theboot999/Teensy-DIY/Photos/PCB4.PNG

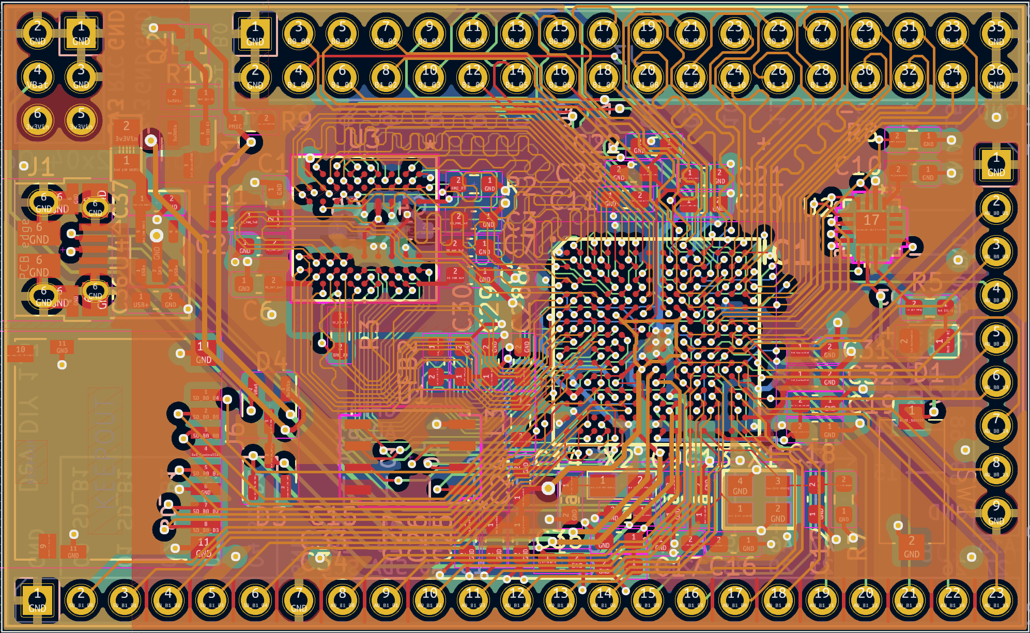
Photos/PCB4.PNG
