theboot999/Teensy-DIY/Photos/PCB3.PNG

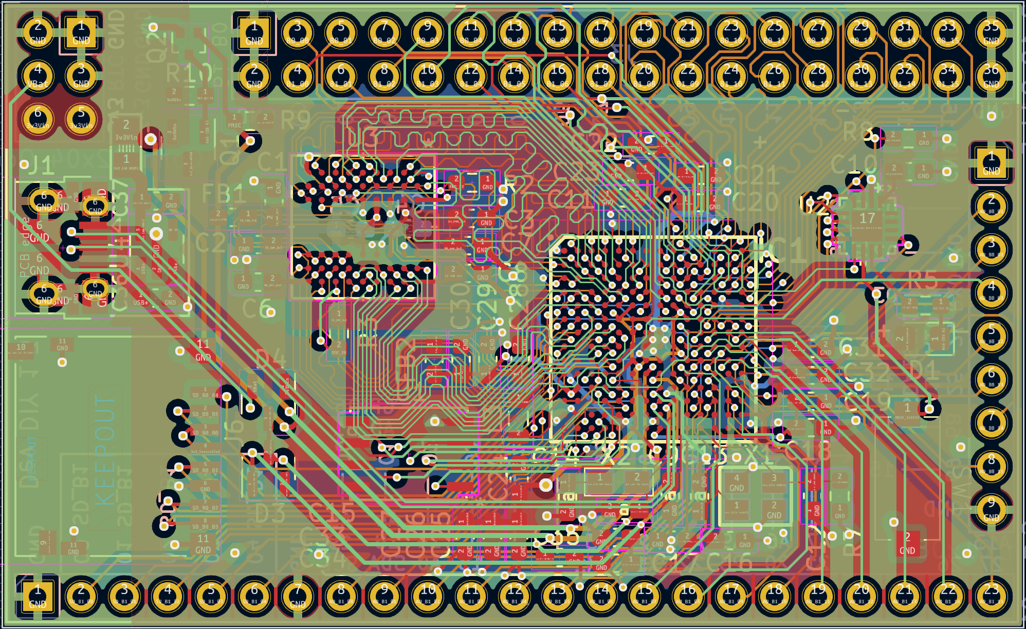
Photos/PCB3.PNG
