theboot999/Teensy-DIY/Photos/Bottom.jpg

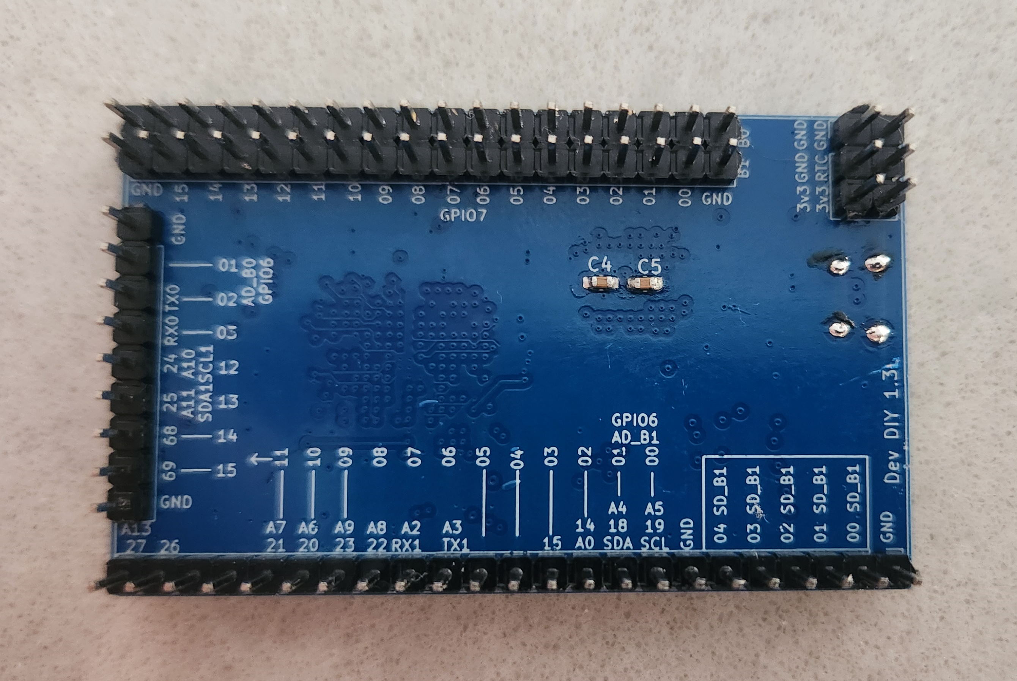
Photos/Bottom.jpg
