theboot999/Teensy-DIY/Photos/Compare.jpg

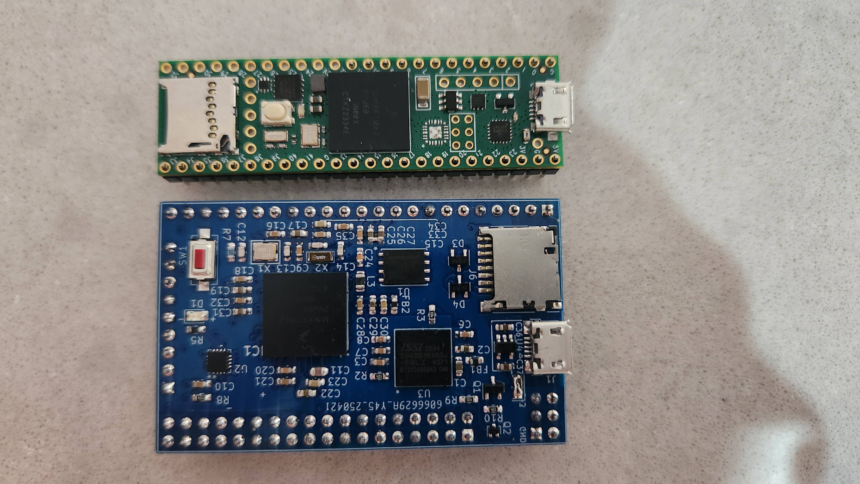
Photos/Compare.jpg
