theboot999/Teensy-DIY/Photos/PCB1.PNG

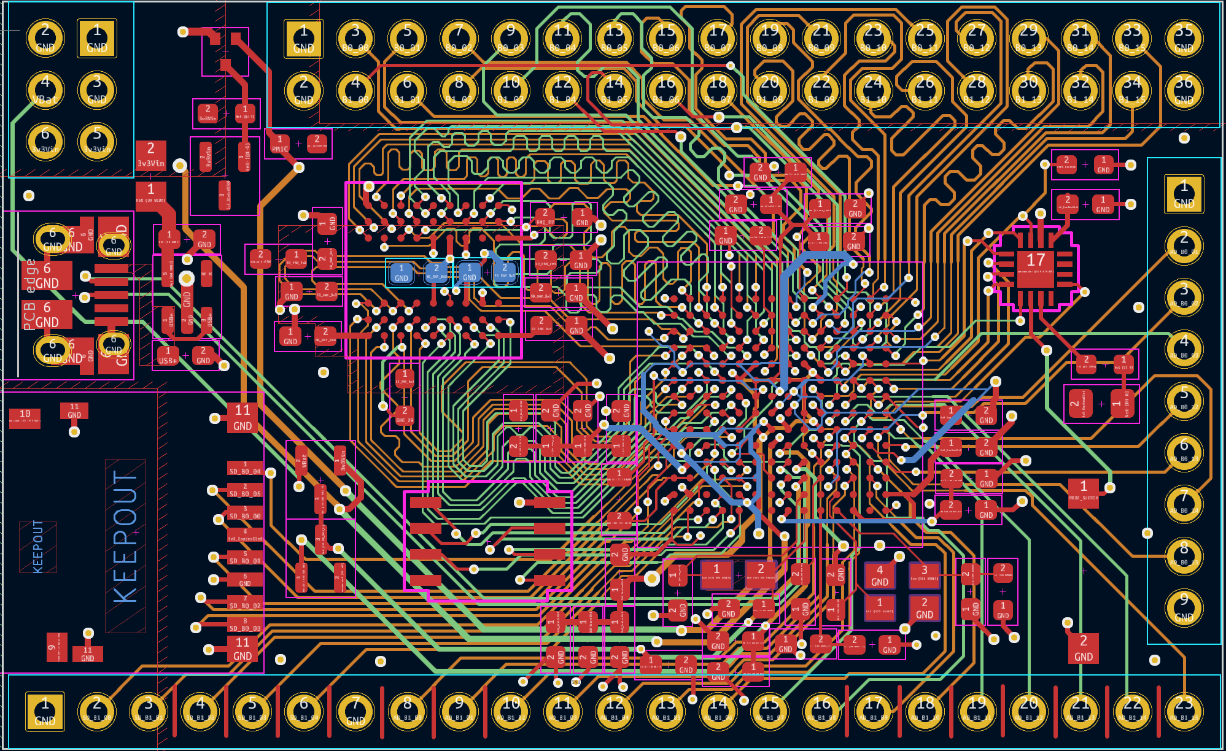
Photos/PCB1.PNG
