theboot999/Teensy-DIY/Photos/PCB2.PNG

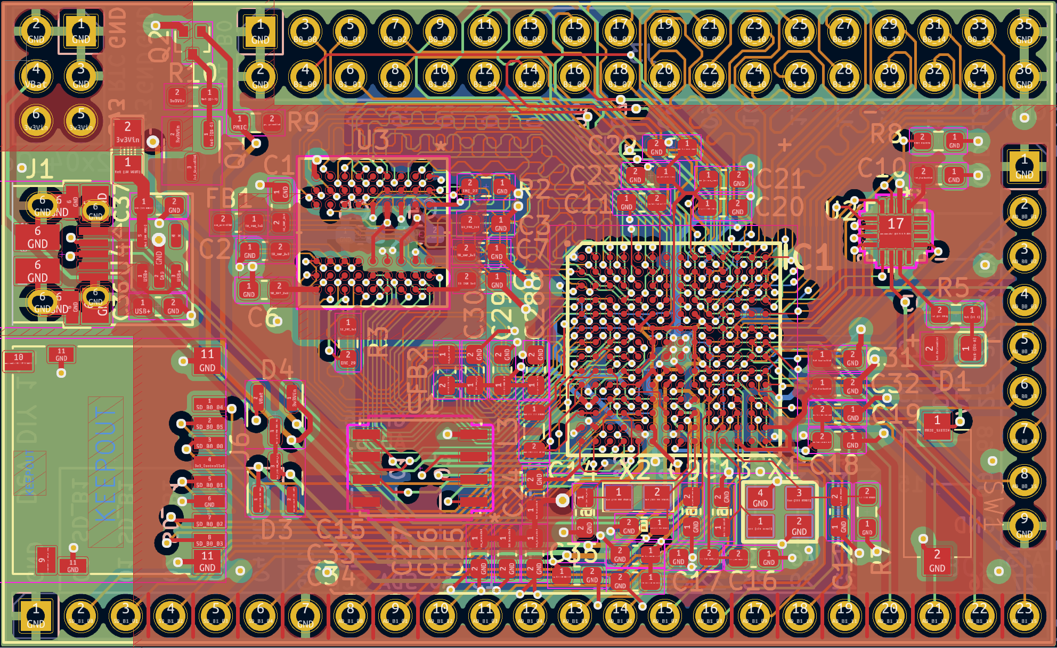
Photos/PCB2.PNG
