theboot999/Teensy-DIY/Photos/PCB5.PNG

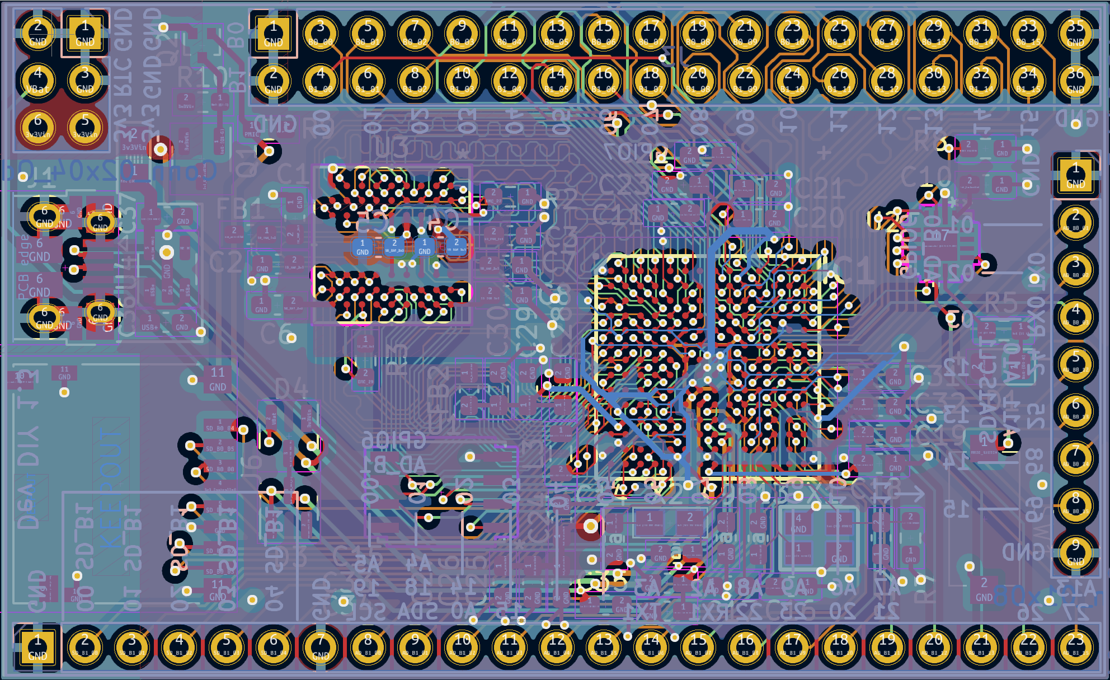
Photos/PCB5.PNG
