theboot999/Teensy-DIY/Photos/Top.jpg

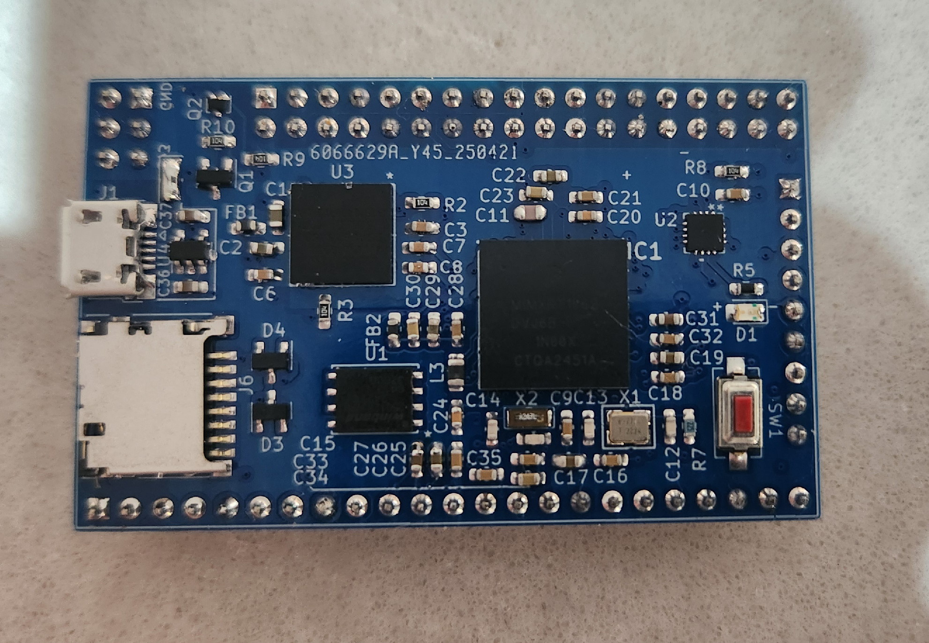
Photos/Top.jpg
