theboot999/Teensy-DIY/Parts List.xlsx

Qty | Description | Product | Package Size | Designator | Link
1 | Microcontroller 12x12 | MIMXRT1062DVJ6B_BGA196 | BGC 12x12 | IC1 | https://au.mouser.com/ProductDetail/NXP-Semiconductors/MIMXRT1062DVJ6B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
1 | Flash Memory 128 mB | W25Q128JVPIM | WSON-8 | U1 | https://au.mouser.com/ProductDetail/Winbond/W25Q128JVPIM?qs=qSfuJ%252Bfl%2Fd62hi5N%252Bd7%252B%252BA%3D%3D
1 | Boot Loader | MKL02Z32_T4_QFN16 | QFN-16 | U2 | https://www.pjrc.com/store/ic_mkl02_t4.html
1 | Ram Chip | IS42S16160J-6BLI | BGA-54 | U3 | https://au.mouser.com/ProductDetail/ISSI/IS42S16160J-6BLI?qs=bHq4TaS7gBeegvGnUO%252BBjw%3D%3D
1 | P Channel Mosfet | DMG2305UXQ-7 | SOT-23-3 | Q1 | https://www.mouser.com/ProductDetail/Diodes-Incorporated/DMG2305UXQ-7?qs=60RJRzIpcl%2FUiAojHt1c9w%3D%3D
1 | N Channel Mosfet | RE1C002UNTCL | SOT-416 | Q2 | https://au.mouser.com/ProductDetail/ROHM-Semiconductor/RE1C002UNTCL?qs=npTsUczJOtMVMYYXsT30%252BQ%3D%3D
1 | USB-B Micro | 10103594-0001LF |  | J1 | https://au.mouser.com/ProductDetail/Amphenol-FCI/10103594-0001LF?qs=EnLMdcWnKABYZwdMsmC%2Fag%3D%3D
1 | Clock 32.768khz | Q13FC1350000400 | 3.2 mm x 1.5 mm | X2 | https://au.mouser.com/ProductDetail/Epson-Timing/FC-135-32.7680KA-A5?qs=f9yNj16SXrJ7J65t%252BHv0JQ%3D%3D
1 | Clock 24mhz | TSX-3225 24.0000MF20G-AC0 | 3.2 mm x 2.5 mm | X1 | https://au.mouser.com/ProductDetail/Epson-Timing/TSX-3225-24.0000MF20G-AC0?qs=wwacUt%252BV97uUWXrbfzMUpw%3D%3D
2 | BAT54C Shottky Diode | BAT54C/SOT23/TO-236AB | SOT-23-3 | D3, D4 | https://au.mouser.com/ProductDetail/Nexperia/BAT54C215?qs=me8TqzrmIYV5SKKt13YKQA%3D%3D&gad_source=1
1 | SD CARD | DM3D-SF(41) |  | J6 | https://au.mouser.com/ProductDetail/Hirose-Connector/DM3D-SF41?qs=tTj%252BmQ3KZwbYpj6JXEwW%2Fg%3D%3D
1 | Button | PTS636SKG25JSMTR LFS |  | SW1 | https://au.mouser.com/ProductDetail/CK/PTS636SKG25JSMTR-LFS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
1 | 3.3V Regulator | AP2112K-3.3TRG1 | SOT-25-5 | U4 | https://au.mouser.com/ProductDetail/Diodes-Incorporated/AP2112K-3.3TRG1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
2 | Ferrite Bead 0603 120Ω | MH1608-121Y | 603 | FB1, FB2 | https://www.mouser.com/ProductDetail/Bourns/MH1608-121Y
1 | Inductor 0805 4.7UH | LQM21PN4R7MGRD | 805 | L3 | https://au.mouser.com/ProductDetail/Murata-Electronics/LQM21PN4R7MGRD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
1 | Led 0805 Red | SML-LX0805IC-TR | 805 | D1 | https://au.mouser.com/ProductDetail/Lumex/SML-LX0805IC-TR?qs=sGAEpiMZZMt82OzCyDsLFLxiYV1ppX3oZmGBhJKofL4%3D
6 | 100k Resistor 0603 | ERA-3AED104V | 603 | R1, R2, R3, R7, R8, R9, R10 | https://au.mouser.com/ProductDetail/Panasonic/ERA-3AED104V
1 | 1k Resistor 0603 | CRCW06031K00FKED | 603 | R5 | https://au.mouser.com/ProductDetail/Vishay-Dale/CRCW06031K00FKED
1 | 2.2M Resistor 0603 | RK73H1JRTTD2204F | 603 | R7 | https://au.mouser.com/ProductDetail/KOA-Speer/RK73H1JRTTD2204F
6 | 0.1uf Capacitor 0603 | KGM15AR71A104KT | 603 | C3, C4, C5, C6, C7, C8 | https://au.mouser.com/ProductDetail/KYOCERA-AVX/KGM15AR71A104KT?qs=OcgtsXO%252B3guqUxqtWAbA9A%3D%3D
6 | 4.7uf Capacitor 0603 | LMK107BJ475KA-T | 603 | C2, C17, C19, C22, C26, C29 | https://au.mouser.com/ProductDetail/TAIYO-YUDEN/LMK107BJ475KA-T?qs=PzICbMaShUfCoRlxZeLF0g%3D%3D
5 | 10pf Capacitor 0603 | VJ0603A100FXQPW1BC | 603 | C11, C12, C13, C14, C15 | https://au.mouser.com/ProductDetail/Vishay-Vitramon/VJ0603A100FXQPW1BC?qs=ivd3pYEy43PNDQsvAciBCA%3D%3D
1 | 22uf Capacitor 0603 | KAM15CT70J226KT | 603 | C1 | https://au.mouser.com/ProductDetail/KYOCERA-AVX/KAM15CT70J226KT
10 | 0.22uf Capacitor 0603 | GRM188R71A224KA01J | 603 | C9,C10,C16,C18,C21,C25,C28,C32,C33,C35 | https://au.mouser.com/ProductDetail/Murata-Electronics/GRM188R71A224KA01J?qs=o%252B57EFQVsgKpqp8gwRHOAA%3D%3D
2 | 0.01uf Capacitor 0603 | 885012206014 | 603 | C20, C24 | https://au.mouser.com/ProductDetail/Wurth-Elektronik/885012206014?qs=0KOYDY2FL2%252BG40IIH78uMA%3D%3D
2 | 10uf Capacitor 0603 | GRM188R61A106ME69D | 603 | C30,C23,C34 | https://au.mouser.com/ProductDetail/Murata-Electronics/GRM188R61A106ME69D?qs=o98hbGm2QKGN31NsNZp5HQ%3D%3D
4 | 2.2uf Capacitor 0603 | LMK107B7225KA-TR | 603 | C27,C31,C36,C37 | https://au.mouser.com/ProductDetail/TAIYO-YUDEN/LMK107B7225KA-TR?qs=vF%252B8ahGVildKPUFyo2XZuA%3D%3D
