theboot999/Teensy-DIY/Schematic.pdf

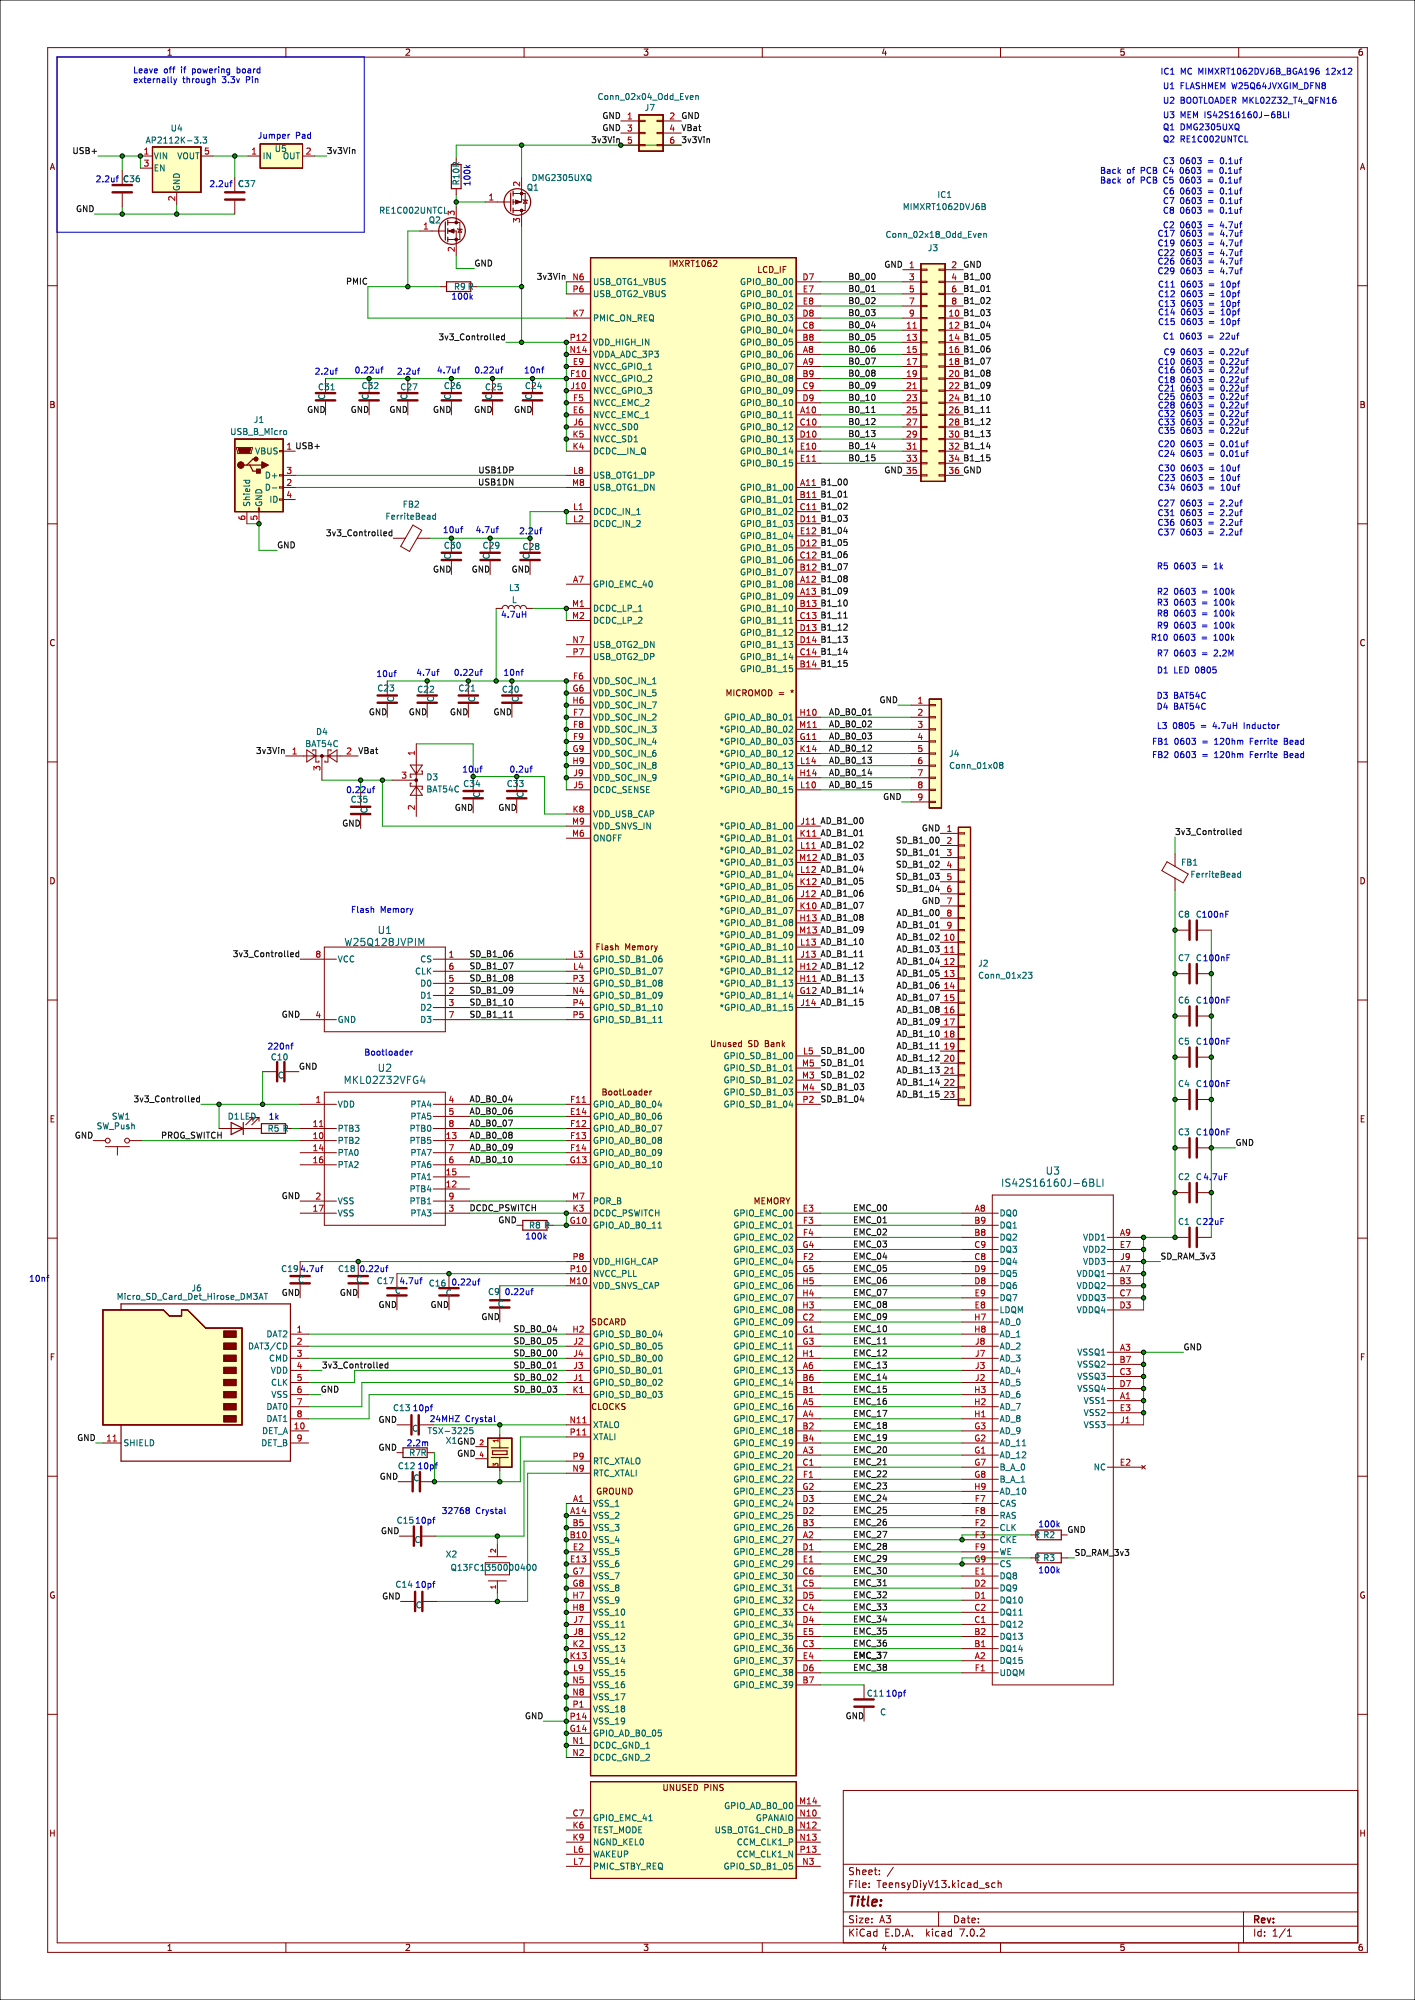
[picture p10: page 1]
