theboot999/Teensy-DIY/Kicad/TeensyDiyV13/TeensyDiyV13.kicad_pcb

## KiCad design Kicad/TeensyDiyV13/TeensyDiyV13.kicad_pcb (2025-04-29)

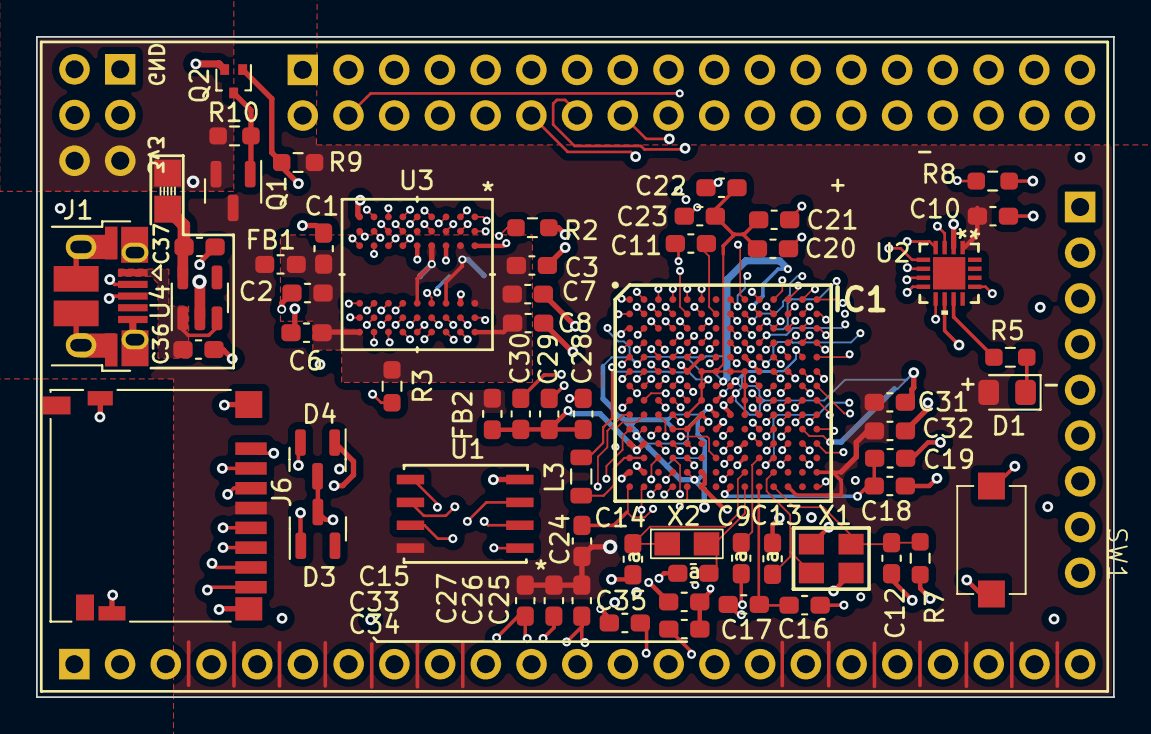
[picture p11: board TeensyDiyV13.kicad_pcb from above]

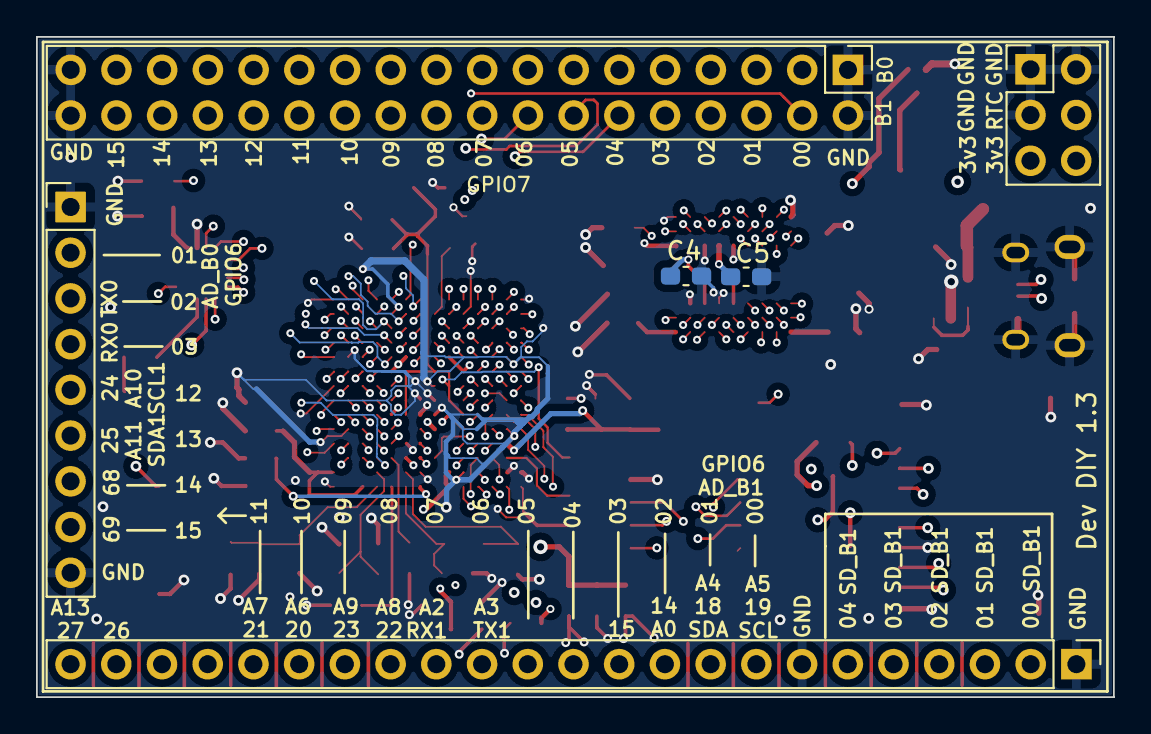
[picture p12: board TeensyDiyV13.kicad_pcb from below]

Board: 4 copper layers, 59.8 x 36.7 mm, 67 parts (6 on the bottom side), 146 nets.

Parts:
C1, C2, C3, C4, C5, C6, C7, C8, C9, C10, C11, C12, C13, C14, C15, C16, C17, C18, C19, C20, C21, C22, C23, C24, C25, C26, C27, C28, C29, C30, C31, C32, C33, C34, C35, C36, C37: C; C_0603_1608Metric_Pad1.08x0.95mm_HandSolder
D1: LED; LED_0805_2012Metric_Pad1.15x1.40mm_HandSolder
D3, D4: BAT54C; SOT-23
FB1, FB2: FerriteBead; L_0603_1608Metric_Pad1.05x0.95mm_HandSolder
IC1: MIMXRT1062DVJ6B; BGA196C80P14X14_1200X1200X152
J1: USB_B_Micro; USB_Micro-B_Amphenol_10103594-0001LF_Horizontal
J2: Conn_01x23; PinHeader_1x23_P2.54mm_Vertical
J3: Conn_02x18_Odd_Even; PinHeader_2x18_P2.54mm_Vertical
J4: Conn_01x08; PinHeader_1x09_P2.54mm_Vertical
J6: Micro_SD_Card_Det_Hirose_DM3AT; microSD_HC_Hirose_DM3D-SF
J7: Conn_02x04_Odd_Even; PinHeader_2x03_P2.54mm_Vertical
L3: L; L_0805_2012Metric
Q1: DMG2305UXQ; SOT-23
Q2: RE1C002UNTCL; SOT-416
R2, R3, R5, R7, R8, R9, R10: R; R_0603_1608Metric_Pad0.98x0.95mm_HandSolder
SW1: SW_Push; PTS636Button
U1: W25Q128JVPIM; Smaller_SOIC_128JVPIM_WIN
U2: MKL02Z32VFG4; QFN-16_3X3X0.65_NXP
U3: IS42S16160J-6BLI; TFBGA-54_8X8_ISI
U4: AP2112K-3.3; SOT-23-5
U5: Bridge
X1: TSX-3225
X2: Q13FC1350000400; XTAL_FC-135_EPS

Connections:
/3v3Vin: D4.1, IC1.N6 (USB_OTG1_VBUS), IC1.P6 (USB_OTG2_VBUS), J7.5, J7.6, Q1.2 (S), R10.2, U5.2 (OUT)
/3v3_Controlled: C10.2, C24.1, C25.1, C26.1, C27.1, C31.1, C32.1, D1.2 (A), FB1.2, FB2.1, IC1.E6 (NVCC_EMC_1), IC1.E9 (NVCC_GPIO_1), IC1.F5 (NVCC_EMC_2), IC1.F10 (NVCC_GPIO_2), IC1.J6 (NVCC_SD0), IC1.J10 (NVCC_GPIO_3), IC1.K4 (DCDC__IN_Q), IC1.K5 (NVCC_SD1), IC1.N14 (VDDA_ADC_3P3), IC1.P12 (VDD_HIGH_IN), J6.4 (VDD), Q1.3 (D), R9.2, U1.8 (VCC), U2.1 (VDD)
/AD_B0_01: IC1.H10 (GPIO_AD_B0_01), J4.2
/AD_B0_02: IC1.M11 (*GPIO_AD_B0_02), J4.3
/AD_B0_03: IC1.G11 (*GPIO_AD_B0_03), J4.4
/AD_B0_04: IC1.F11 (GPIO_AD_B0_04), U2.4 (PTA4)
/AD_B0_06: IC1.E14 (GPIO_AD_B0_06), U2.5 (PTA5)
/AD_B0_07: IC1.F12 (GPIO_AD_B0_07), U2.8 (PTB0)
/AD_B0_08: IC1.F13 (GPIO_AD_B0_08), U2.13 (PTB5)
/AD_B0_09: IC1.F14 (GPIO_AD_B0_09), U2.7 (PTA7)
/AD_B0_10: IC1.G13 (GPIO_AD_B0_10), U2.6 (PTA6)
/AD_B0_12: IC1.K14 (*GPIO_AD_B0_12), J4.5
/AD_B0_13: IC1.L14 (*GPIO_AD_B0_13), J4.6
/AD_B0_14: IC1.H14 (*GPIO_AD_B0_14), J4.7
/AD_B0_15: IC1.L10 (*GPIO_AD_B0_15), J4.8
/AD_B1_00: IC1.J11 (*GPIO_AD_B1_00), J2.8
/AD_B1_01: IC1.K11 (*GPIO_AD_B1_01), J2.9
/AD_B1_02: IC1.L11 (*GPIO_AD_B1_02), J2.10
/AD_B1_03: IC1.M12 (*GPIO_AD_B1_03), J2.11
/AD_B1_04: IC1.L12 (*GPIO_AD_B1_04), J2.12
/AD_B1_05: IC1.K12 (*GPIO_AD_B1_05), J2.13
/AD_B1_06: IC1.J12 (*GPIO_AD_B1_06), J2.14
/AD_B1_07: IC1.K10 (*GPIO_AD_B1_07), J2.15
/AD_B1_08: IC1.H13 (*GPIO_AD_B1_08), J2.16
/AD_B1_09: IC1.M13 (*GPIO_AD_B1_09), J2.17
/AD_B1_10: IC1.L13 (*GPIO_AD_B1_10), J2.18
/AD_B1_11: IC1.J13 (*GPIO_AD_B1_11), J2.19
/AD_B1_12: IC1.H12 (*GPIO_AD_B1_12), J2.20
/AD_B1_13: IC1.H11 (*GPIO_AD_B1_13), J2.21
/AD_B1_14: IC1.G12 (*GPIO_AD_B1_14), J2.22
/AD_B1_15: IC1.J14 (*GPIO_AD_B1_15), J2.23
/B0_00: IC1.D7 (GPIO_B0_00), J3.3
/B0_01: IC1.E7 (GPIO_B0_01), J3.5
/B0_02: IC1.E8 (GPIO_B0_02), J3.7
/B0_03: IC1.D8 (GPIO_B0_03), J3.9
/B0_04: IC1.C8 (GPIO_B0_04), J3.11
/B0_05: IC1.B8 (GPIO_B0_05), J3.13
/B0_06: IC1.A8 (GPIO_B0_06), J3.15
/B0_07: IC1.A9 (GPIO_B0_07), J3.17
/B0_08: IC1.B9 (GPIO_B0_08), J3.19
/B0_09: IC1.C9 (GPIO_B0_09), J3.21
/B0_10: IC1.D9 (GPIO_B0_10), J3.23
/B0_11: IC1.A10 (GPIO_B0_11), J3.25
/B0_12: IC1.C10 (GPIO_B0_12), J3.27
/B0_13: IC1.D10 (GPIO_B0_13), J3.29
/B0_14: IC1.E10 (GPIO_B0_14), J3.31
/B0_15: IC1.E11 (GPIO_B0_15), J3.33
/B1_00: IC1.A11 (GPIO_B1_00), J3.4
/B1_01: IC1.B11 (GPIO_B1_01), J3.6
/B1_02: IC1.C11 (GPIO_B1_02), J3.8
/B1_03: IC1.D11 (GPIO_B1_03), J3.10
/B1_04: IC1.E12 (GPIO_B1_04), J3.12
/B1_05: IC1.D12 (GPIO_B1_05), J3.14
/B1_06: IC1.C12 (GPIO_B1_06), J3.16
/B1_07: IC1.B12 (GPIO_B1_07), J3.18
/B1_08: IC1.A12 (GPIO_B1_08), J3.20
/B1_09: IC1.A13 (GPIO_B1_09), J3.22
/B1_10: IC1.B13 (GPIO_B1_10), J3.24
/B1_11: IC1.C13 (GPIO_B1_11), J3.26
/B1_12: IC1.D13 (GPIO_B1_12), J3.28
/B1_13: IC1.D14 (GPIO_B1_13), J3.30
/B1_14: IC1.C14 (GPIO_B1_14), J3.32
/B1_15: IC1.B14 (GPIO_B1_15), J3.34
/DCDC_PSWITCH: IC1.G10 (GPIO_AD_B0_11), IC1.K3 (DCDC_PSWITCH), R8.2, U2.3 (PTA3)
/EMC_00: IC1.E3 (GPIO_EMC_00), U3.A8 (DQ0)
/EMC_01: IC1.F3 (GPIO_EMC_01), U3.B9 (DQ1)
/EMC_02: IC1.F4 (GPIO_EMC_02), U3.B8 (DQ2)
/EMC_3: IC1.E4 (GPIO_EMC_37), U3.A2 (DQ15)
/EMC_03: IC1.G4 (GPIO_EMC_03), U3.C9 (DQ3)
/EMC_04: IC1.F2 (GPIO_EMC_04), U3.C8 (DQ4)
/EMC_05: IC1.G5 (GPIO_EMC_05), U3.D9 (DQ5)
/EMC_06: IC1.H5 (GPIO_EMC_06), U3.D8 (DQ6)
/EMC_07: IC1.H4 (GPIO_EMC_07), U3.E9 (DQ7)
/EMC_08: IC1.H3 (GPIO_EMC_08), U3.E8 (LDQM)
/EMC_09: IC1.C2 (GPIO_EMC_09), U3.H7 (AD_0)
/EMC_10: IC1.G1 (GPIO_EMC_10), U3.H8 (AD_1)
/EMC_11: IC1.G3 (GPIO_EMC_11), U3.J8 (AD_2)
/EMC_12: IC1.H1 (GPIO_EMC_12), U3.J7 (AD_3)
/EMC_13: IC1.A6 (GPIO_EMC_13), U3.J3 (AD_4)
/EMC_14: IC1.B6 (GPIO_EMC_14), U3.J2 (AD_5)
/EMC_15: IC1.B1 (GPIO_EMC_15), U3.H3 (AD_6)
/EMC_16: IC1.A5 (GPIO_EMC_16), U3.H2 (AD_7)
/EMC_17: IC1.A4 (GPIO_EMC_17), U3.H1 (AD_8)
/EMC_18: IC1.B2 (GPIO_EMC_18), U3.G3 (AD_9)
/EMC_19: IC1.B4 (GPIO_EMC_19), U3.G2 (AD_11)
/EMC_20: IC1.A3 (GPIO_EMC_20), U3.G1 (AD_12)
/EMC_21: IC1.C1 (GPIO_EMC_21), U3.G7 (B_A_0)
/EMC_22: IC1.F1 (GPIO_EMC_22), U3.G8 (B_A_1)
/EMC_23: IC1.G2 (GPIO_EMC_23), U3.H9 (AD_10)
/EMC_24: IC1.D3 (GPIO_EMC_24), U3.F7 (CAS)
/EMC_25: IC1.D2 (GPIO_EMC_25), U3.F8 (RAS)
/EMC_26: IC1.B3 (GPIO_EMC_26), U3.F2 (CLK)
/EMC_27: IC1.A2 (GPIO_EMC_27), R2.2, U3.F3 (CKE)
/EMC_28: IC1.D1 (GPIO_EMC_28), U3.F9 (WE)
/EMC_29: IC1.E1 (GPIO_EMC_29), R3.2, U3.G9 (CS)
/EMC_30: IC1.C6 (GPIO_EMC_30), U3.E1 (DQ8)
/EMC_31: IC1.C5 (GPIO_EMC_31), U3.D2 (DQ9)
/EMC_32: IC1.D5 (GPIO_EMC_32), U3.D1 (DQ10)
/EMC_33: IC1.C4 (GPIO_EMC_33), U3.C2 (DQ11)
/EMC_34: IC1.D4 (GPIO_EMC_34), U3.C1 (DQ12)
/EMC_35: IC1.E5 (GPIO_EMC_35), U3.B2 (DQ13)
/EMC_36: IC1.C3 (GPIO_EMC_36), U3.B1 (DQ14)
/EMC_38: IC1.D6 (GPIO_EMC_38), U3.F1 (UDQM)
/GND: C1.1, C2.1, C3.1, C4.1, C5.1, C6.1, C7.1, C8.1, C9.1, C10.1, C11.1, C12.1, C13.2, C14.2, C15.2, C16.1, C17.1, C18.1, C19.1, C20.2, C21.2, C22.2, C23.2, C24.2, C25.2, C26.2, C27.2, C28.2, C29.2, C30.2, C31.2, C32.2, C33.2, C34.2, C35.2, C36.2, C37.2, IC1.A1 (VSS_1), IC1.A14 (VSS_2), IC1.B5 (VSS_3), IC1.B10 (VSS_4), IC1.E2 (VSS_5), IC1.E13 (VSS_6), IC1.G7 (VSS_7), IC1.G8 (VSS_8), IC1.G14 (GPIO_AD_B0_05), IC1.H7 (VSS_9), IC1.H8 (VSS_10), IC1.J7 (VSS_11), IC1.J8 (VSS_12), IC1.K2 (VSS_13), IC1.K13 (VSS_14), IC1.L9 (VSS_15), IC1.N1 (DCDC_GND_1), IC1.N2 (DCDC_GND_2), IC1.N5 (VSS_16), IC1.N8 (VSS_17), IC1.P1 (VSS_18), IC1.P14 (VSS_19), J1.5 (GND), J1.6 (Shield), J2.1, J2.7, J3.1, J3.2, J3.35, J3.36, J4.1, J4.9, J6.6 (VSS), J6.11 (SHIELD), J7.1, J7.2, J7.3, Q2.2 (S), R2.1, R7.1, R8.1, SW1.2, U1.4 (GND), U2.2 (VSS), U3.A1 (VSS1), U3.A3 (VSSQ1), U3.B7 (VSSQ2), U3.C3 (VSSQ3), U3.D7 (VSSQ4), U3.E3 (VSS2), U3.J1 (VSS3), U4.2 (GND), X1.2, X1.4
/PMIC: IC1.K7 (PMIC_ON_REQ), Q2.1 (G), R9.1
/PROG_SWITCH: SW1.1, U2.10 (PTB2)
/SD_B0_00: IC1.J4 (GPIO_SD_B0_00), J6.3 (CMD)
/SD_B0_01: IC1.J3 (GPIO_SD_B0_01), J6.5 (CLK)
/SD_B0_02: IC1.J1 (GPIO_SD_B0_02), J6.7 (DAT0)
/SD_B0_03: IC1.K1 (GPIO_SD_B0_03), J6.8 (DAT1)
/SD_B0_04: IC1.H2 (GPIO_SD_B0_04), J6.1 (DAT2)
/SD_B0_05: IC1.J2 (GPIO_SD_B0_05), J6.2 (DAT3/CD)
/SD_B1_00: IC1.L5 (GPIO_SD_B1_00), J2.2
/SD_B1_01: IC1.M5 (GPIO_SD_B1_01), J2.3
/SD_B1_02: IC1.M3 (GPIO_SD_B1_02), J2.4
/SD_B1_03: IC1.M4 (GPIO_SD_B1_03), J2.5
/SD_B1_04: IC1.P2 (GPIO_SD_B1_04), J2.6
/SD_B1_06: IC1.L3 (GPIO_SD_B1_06), U1.1 (CS)
/SD_B1_07: IC1.L4 (GPIO_SD_B1_07), U1.6 (CLK)
/SD_B1_08: IC1.P3 (GPIO_SD_B1_08), U1.5 (D0)
/SD_B1_09: IC1.N4 (GPIO_SD_B1_09), U1.2 (D1)
/SD_B1_10: IC1.P4 (GPIO_SD_B1_10), U1.3 (D2)
/SD_B1_11: IC1.P5 (GPIO_SD_B1_11), U1.7 (D3)
/SD_RAM_3v3: C1.2, C2.2, C3.2, C4.2, C5.2, C6.2, C7.2, C8.2, FB1.1, R3.1, U3.A7 (VDDQ1), U3.A9 (VDD1), U3.B3 (VDDQ2), U3.C7 (VDDQ3), U3.D3 (VDDQ4), U3.E7 (VDD2), U3.J9 (VDD3)
/USB1DN: IC1.M8 (USB_OTG1_DN), J1.2 (D-)
/USB1DP: IC1.L8 (USB_OTG1_DP), J1.3 (D+)
/USB+: C36.1, J1.1 (VBUS), U4.1 (VIN), U4.3 (EN)
/VBat: D4.2, J7.4
unnamed: D1.1 (K), R5.1
unnamed: C28.1, C29.1, C30.1, FB2.2, IC1.L1 (DCDC_IN_1), IC1.L2 (DCDC_IN_2)
unnamed: IC1.M1 (DCDC_LP_1), IC1.M2 (DCDC_LP_2), L3.2
unnamed: C20.1, C21.1, C22.1, C23.1, IC1.F6 (VDD_SOC_IN_1), IC1.F7 (VDD_SOC_IN_2), IC1.F8 (VDD_SOC_IN_3), IC1.F9 (VDD_SOC_IN_4), IC1.G6 (VDD_SOC_IN_5), IC1.G9 (VDD_SOC_IN_6), IC1.H6 (VDD_SOC_IN_7), IC1.H9 (VDD_SOC_IN_8), IC1.J5 (DCDC_SENSE), IC1.J9 (VDD_SOC_IN_9), L3.1
unnamed: C11.2, IC1.B7 (GPIO_EMC_39)
unnamed: C16.2, C17.2, IC1.P10 (NVCC_PLL)
unnamed: IC1.M7 (POR_B), U2.9 (PTB1)
unnamed: C14.1, IC1.N9 (RTC_XTALI), X2.1
unnamed: C15.1, IC1.P9 (RTC_XTALO), X2.2
unnamed: C18.2, C19.2, IC1.P8 (VDD_HIGH_CAP)
unnamed: C9.2, IC1.M10 (VDD_SNVS_CAP)
unnamed: C35.1, D3.3, D4.3, IC1.M9 (VDD_SNVS_IN)
unnamed: C33.1, C34.1, D3.1, IC1.K8 (VDD_USB_CAP)
unnamed: C12.2, IC1.P11 (XTALI), R7.2, X1.3
unnamed: C13.1, IC1.N11 (XTALO), X1.1
unnamed: Q1.1 (G), Q2.3 (D), R10.1
unnamed: R5.2, U2.11 (PTB3)
unnamed: C37.1, U4.5 (VOUT), U5.1 (IN)
