theboot999/Teensy-DIY/(notices)

Notices in the files:
parts and their libraries:
COPYRIGHT: Copyright (C) 2023 Ultra Librarian. All rights reserved.
